lendai/esphome-house-pressure/enclosure/png/back.png

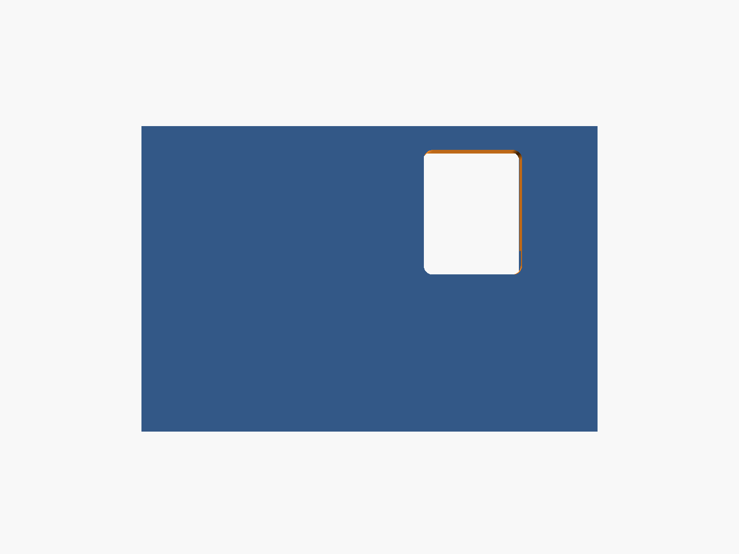
enclosure/png/back.png
