lendai/esphome-house-pressure/enclosure/png/base.png

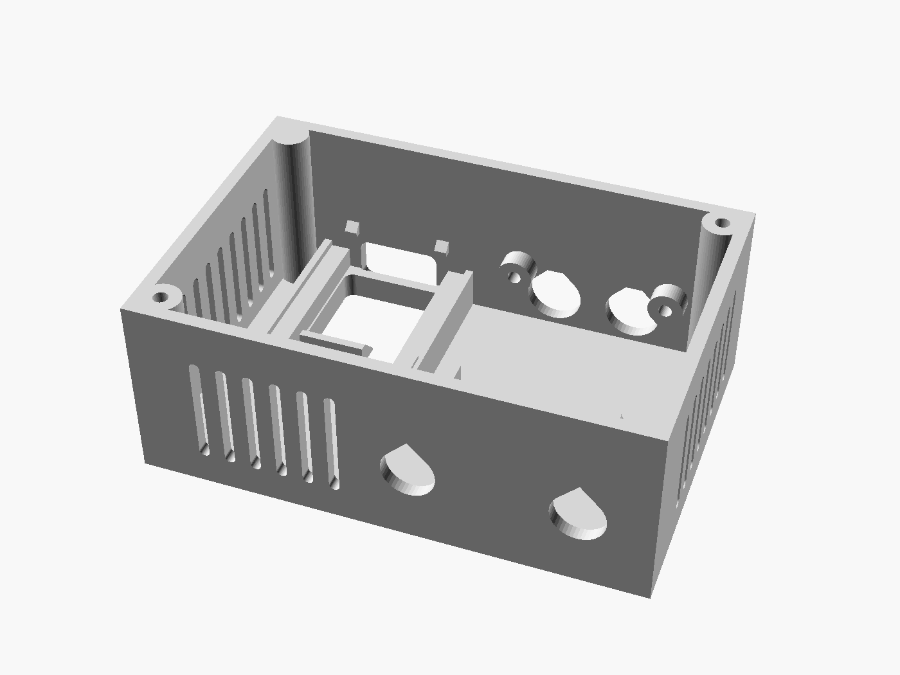
enclosure/png/base.png
