lendai/esphome-house-pressure/enclosure/png/coupon.png

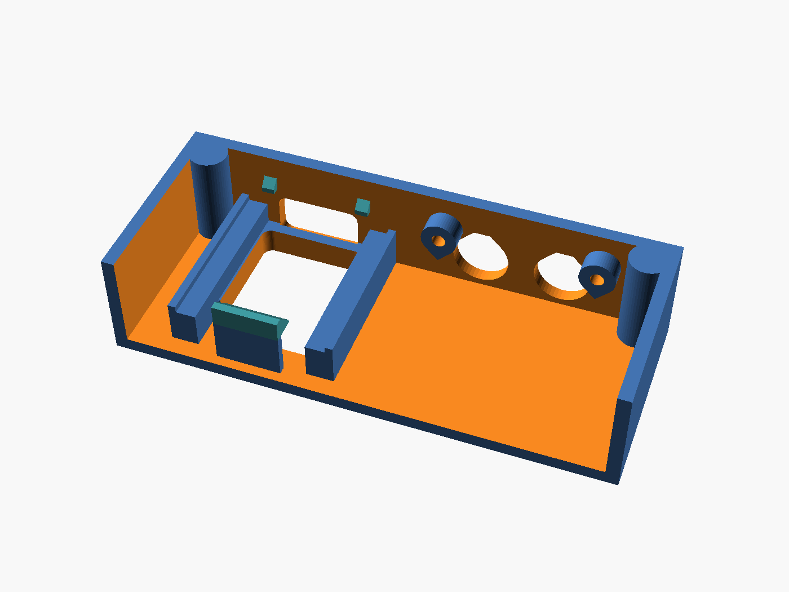
enclosure/png/coupon.png
