lendai/esphome-house-pressure/enclosure/png/lid.png

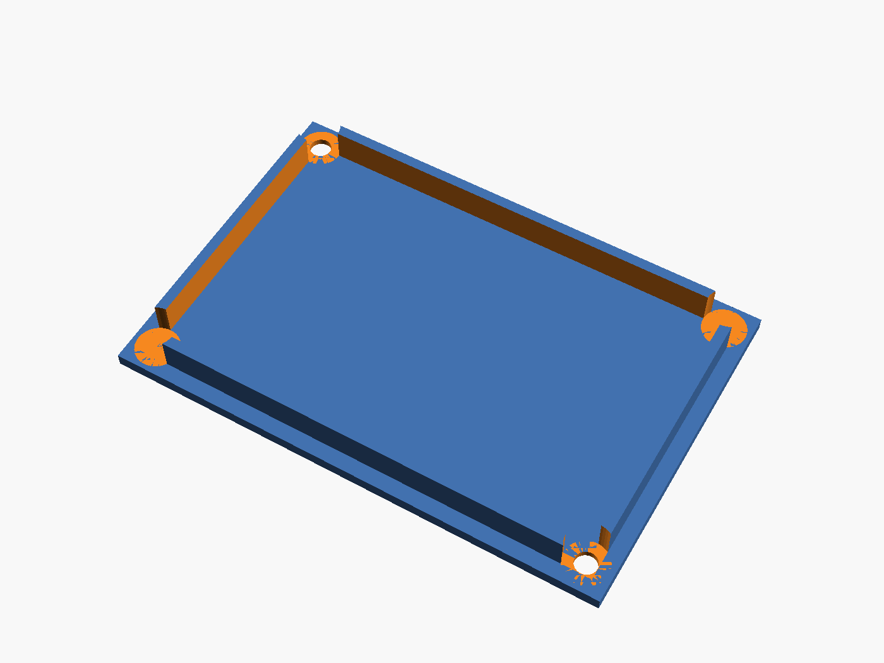
enclosure/png/lid.png
