lendai/esphome-house-pressure/enclosure/png/window-feedthrough.png

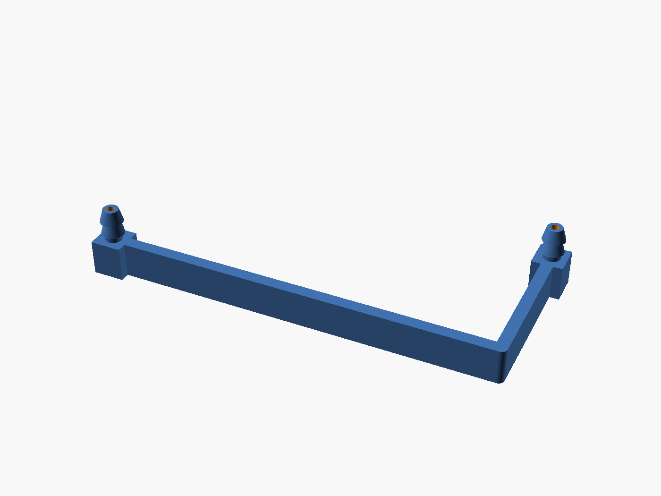
enclosure/png/window-feedthrough.png
