lendai/esphome-house-pressure/enclosure/stl/lid-text.stl

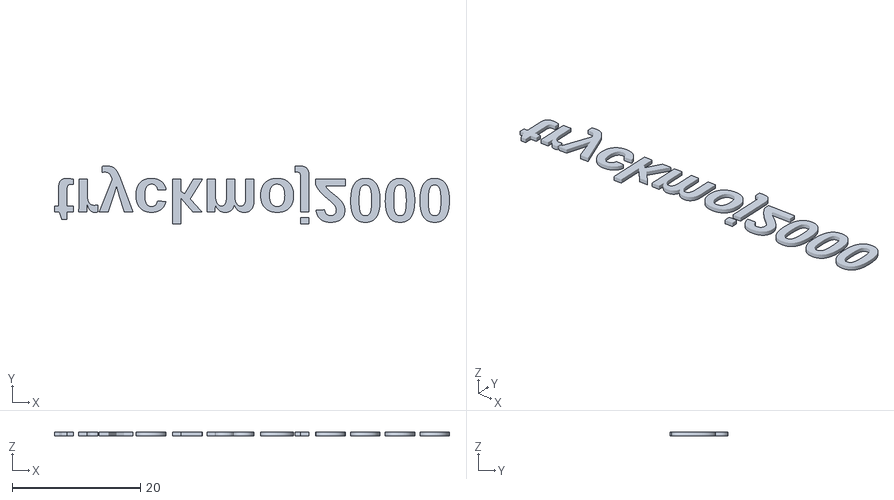
[picture p9: CAD file, 2026-10-29]
enclosure/stl/lid-text.stl
61.6 x 9.06 x 0.6
