lendai/esphome-house-pressure/enclosure/stl/lid-body.stl

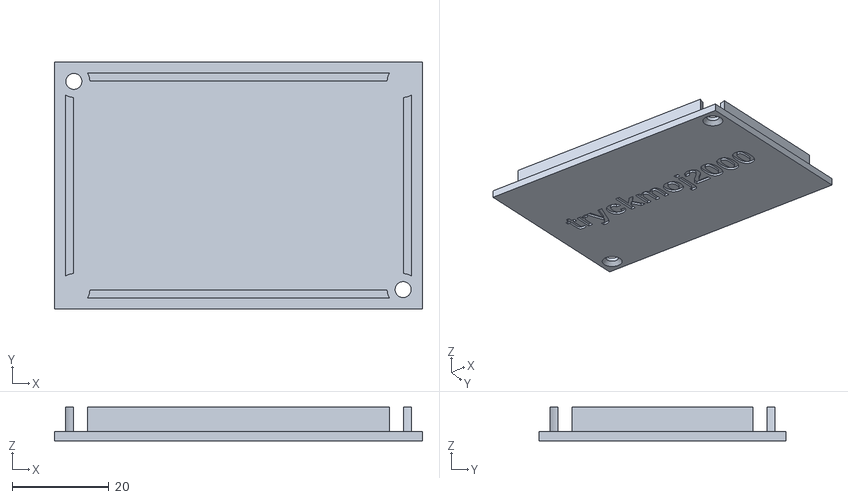
[picture p10: CAD file, 2026-10-29]
enclosure/stl/lid-body.stl
76.0 x 51.0 x 7.00
