lendai/esphome-house-pressure/enclosure/stl/base.stl

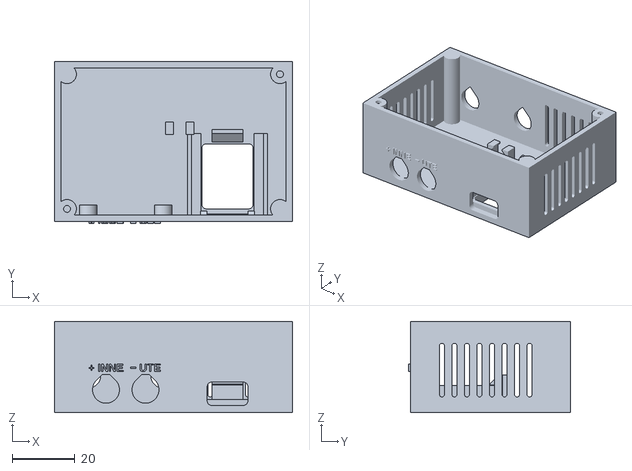
[picture p11: CAD file, 2026-10-29]
enclosure/stl/base.stl
76.0 x 51.6 x 29.1
