lendai/esphome-house-pressure/enclosure/stl/coupon.stl

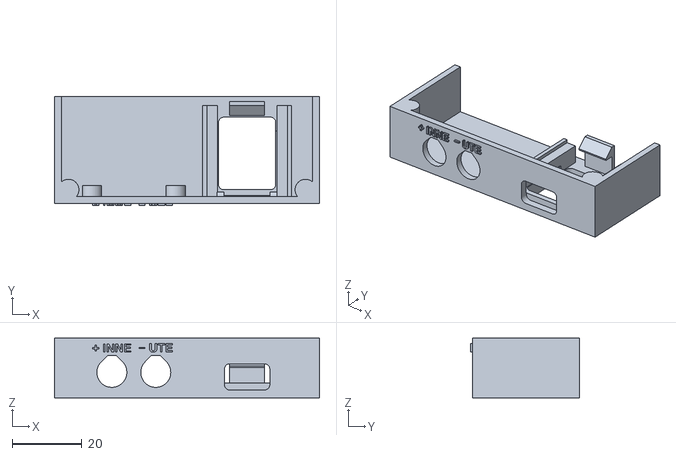
[picture p12: CAD file, 2026-10-28]
enclosure/stl/coupon.stl
76.0 x 31.4 x 17.1
