lendai/esphome-house-pressure/enclosure/stl/window-feedthrough.stl

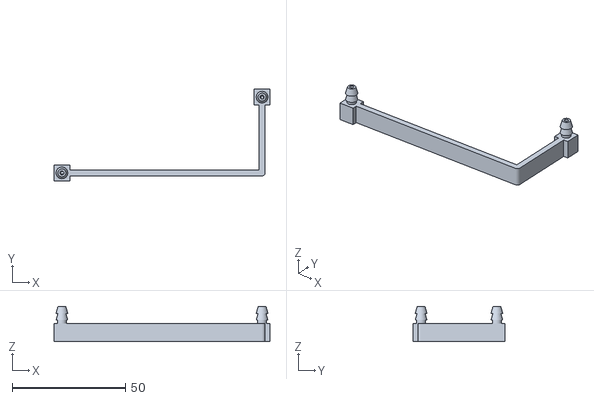
[picture p13: CAD file, 2026-10-28]
enclosure/stl/window-feedthrough.stl
95.5 x 40.5 x 15.5
