lendai/esphome-house-pressure/(list of files, cad)

Other CAD files:
enclosure/stl/lid.stl
