lendai/esphome-house-pressure/enclosure/png/assembly-bottom.png

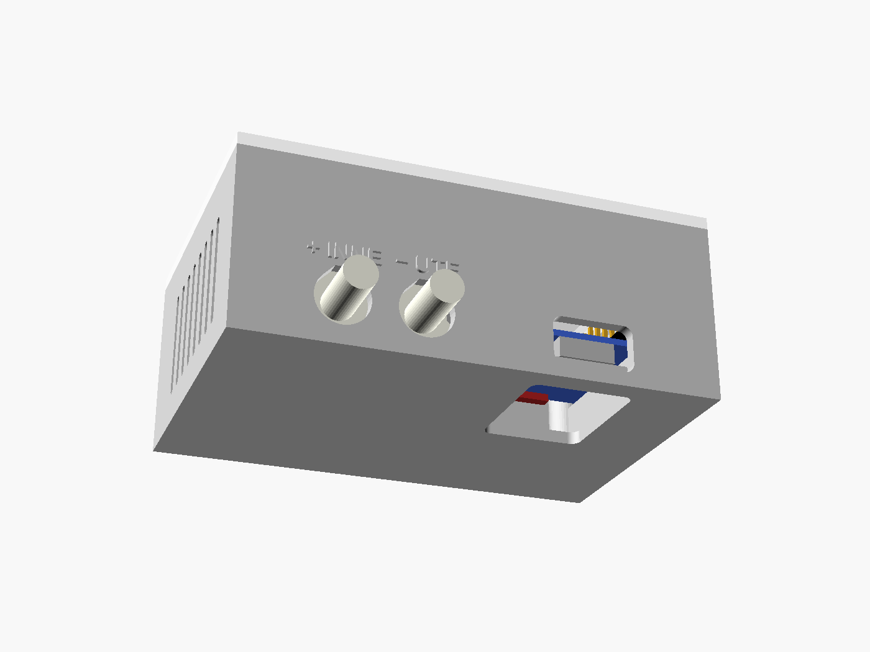
enclosure/png/assembly-bottom.png
