lendai/esphome-house-pressure/enclosure/png/assembly-inside.png

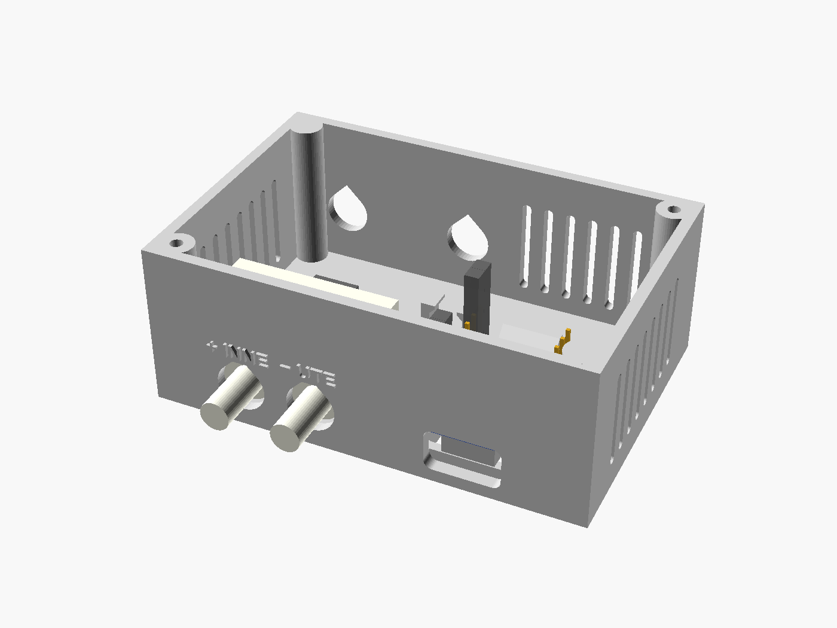
enclosure/png/assembly-inside.png
