lendai/esphome-house-pressure/house-pressure.yaml

substitutions:
  name: house-pressure
  friendly_name: House pressure

esphome:
  name: ${name}
  friendly_name: ${friendly_name}
  on_boot:
    priority: -100
    then:
      - if:
          condition:
            not:
              wifi.connected:
          then:
            - script.execute: led_no_wifi

# Waveshare ESP32-C3-Zero (ESP32-C3FH4, 4 MB flash, native USB Serial/JTAG)
esp32:
  variant: esp32c3
  board: esp32-c3-devkitm-1
  flash_size: 4MB
  framework:
    type: esp-idf

logger:

api:
  encryption:
    key: !secret api_encryption_key
  on_client_connected:
    - script.execute: led_ok
  on_client_disconnected:
    - if:
        condition:
          not:
            api.connected:
        then:
          - script.execute: led_no_homey

ota:
  - platform: esphome
    password: !secret ota_password

wifi:
  ssid: !secret wifi_ssid
  password: !secret wifi_password
  ap:
    ssid: "${name} fallback"
    password: !secret fallback_ap_password
  on_connect:
    - script.execute: led_no_homey
  on_disconnect:
    - script.execute: led_no_wifi

captive_portal:

# Onboard WS2812 on GPIO10 as status LED (Waveshare: RGB data order).
#   red pulse   = no WiFi
#   blue pulse  = WiFi OK, Homey not connected
#   dim green   = connected to Homey
light:
  - platform: esp32_rmt_led_strip
    id: status_led
    name: "Status LED"
    internal: true
    pin: GPIO10
    num_leds: 1
    chipset: WS2812
    channel_colors: RGB
    default_transition_length: 0s
    restore_mode: ALWAYS_OFF
    effects:
      - pulse:
          name: Pulse
          transition_length: 1s
          update_interval: 1s

script:
  - id: led_no_wifi
    mode: restart
    then:
      - light.turn_on:
          id: status_led
          red: 100%
          green: 0%
          blue: 0%
          brightness: 50%
          effect: Pulse
  - id: led_no_homey
    mode: restart
    then:
      - light.turn_on:
          id: status_led
          red: 0%
          green: 0%
          blue: 100%
          brightness: 50%
          effect: Pulse
  - id: led_ok
    mode: restart
    then:
      - light.turn_on:
          id: status_led
          red: 0%
          green: 100%
          blue: 0%
          brightness: 10%
          effect: None

# GPIO4/5: free on the C3-Zero (not strapping 2/8/9, not LED 10, not USB 18/19, not UART 20/21).
# External 4.7 kΩ pull-ups to 3.3 V, so internal pull-ups are off.
i2c:
  sda: GPIO4
  scl: GPIO5
  sda_pullup_enabled: false
  scl_pullup_enabled: false
  frequency: 100kHz
  scan: true

# Positive = "+" port (indoor) higher than "−" port (outdoor).
# Turn on if the tubes are swapped.
switch:
  - platform: template
    id: invert_sign
    name: "Invert pressure sign"
    icon: mdi:swap-vertical
    optimistic: true
    restore_mode: RESTORE_DEFAULT_OFF
    # Offset is stored in the displayed sign convention, so flip it with the sign.
    on_turn_on:
      - number.set:
          id: pressure_offset
          value: !lambda return -id(pressure_offset).state;
    on_turn_off:
      - number.set:
          id: pressure_offset
          value: !lambda return -id(pressure_offset).state;

number:
  - platform: template
    id: pressure_offset
    name: "Pressure offset"
    icon: mdi:tune-vertical
    unit_of_measurement: Pa
    device_class: pressure
    mode: box
    min_value: -25
    max_value: 25
    step: 0.01
    initial_value: 0
    optimistic: true
    restore_value: true

button:
  - platform: template
    name: "Zero calibrate"
    icon: mdi:scale-balance
    on_press:
      - lambda: |-
          float avg = id(pressure_avg).state;
          if (std::isnan(avg)) {
            ESP_LOGW("calib", "No average yet, calibration skipped");
            return;
          }
          // avg already has the old offset subtracted
          float offset = id(pressure_offset).state + avg;
          ESP_LOGI("calib", "New offset: %.2f Pa", offset);
          auto call = id(pressure_offset).make_call();
          call.set_value(offset);
          call.perform();

sensor:
  # sdp3x publishes hPa; convert to Pa. Sign/offset are applied on the outputs.
  - platform: sdp3x
    id: sdp_pa
    address: 0x25
    update_interval: 2s
    internal: true
    unit_of_measurement: Pa
    # Copies inherit this. Empty, so Homey's ESPHome app doesn't map them to
    # measure_pressure, convert Pa to mbar and round a few Pa down to 0.
    device_class: ""
    accuracy_decimals: 2
    filters:
      - multiply: 100

  - platform: copy
    source_id: sdp_pa
    id: pressure_raw
    name: "Pressure indoor-outdoor raw"
    unit_of_measurement: Pa
    state_class: measurement
    accuracy_decimals: 2
    filters:
      - throttle_average: 10s
      - lambda: |-
          return (id(invert_sign).state ? -x : x) - id(pressure_offset).state;

  - platform: copy
    source_id: sdp_pa
    id: pressure_avg
    name: "Pressure indoor-outdoor"
    unit_of_measurement: Pa
    state_class: measurement
    accuracy_decimals: 1
    filters:
      # 150 × 2 s = 5 min window, published every 30 s
      - sliding_window_moving_average:
          window_size: 150
          send_every: 15
          send_first_at: 15
      - lambda: |-
          return (id(invert_sign).state ? -x : x) - id(pressure_offset).state;

  - platform: wifi_signal
    name: "WiFi signal"
    update_interval: 60s

  - platform: uptime
    name: "Uptime"
