lendai/esphome-house-pressure/(commit log)

2026-10-26 Add ESPHome config for SDP810 indoor-outdoor pressure sensor
    ESP32-C3-Zero + SDP810-125Pa on I2C (GPIO4/5, external pull-ups),
    5-min average and raw pressure in Pa, zero-offset calibration,
    sign inversion, README with wiring and Homey setup.
2026-10-26 Show all entities as regular entities
    Drop entity_category from the sign switch, offset, zero-calibrate button
    and the WiFi/uptime sensors so they are not hidden as config/diagnostic.
2026-10-26 Add parametric 3D-printable enclosure
    OpenSCAD model for a wall-mounted box where the base is the carrier:
    SDP810 screwed to bosses on the bottom wall with ports out through it
    ("+ INNE" / "- UTE" embossed), ESP32-C3-Zero-M upside down in a snap
    cradle aligned with a USB-C cutout, wire clip, vents, keyholes, and a
    snap-fit or M3 lid. Includes exported STLs (base, lid, test coupon),
    preview PNGs, a build script and a manifold checker.
    README: pull-ups now go at the SDP810 end of the harness, no breadboard.
    [base.stl, coupon.stl, house-pressure-enclosure.scad, lid.stl]
2026-10-27 Use onboard RGB LED as status light
    Red pulse = no WiFi, blue pulse = no Homey connection, dim green = connected.
2026-10-28 Tune enclosure fit, screw the lid and add window feedthrough
    - Widen and lengthen the C3 cradle (c3_w_play 4.5, c3_l_play 2.0) and
    make the antenna-end snap tab sturdier (1.2 mm thick, 10 mm wide)
    - Screw the lid to four corner bosses with small wood screws by default
    - Enlarge the SDP810 screwdriver access holes to 8 mm
    - Replace the keyhole wall mounts with a back-plate window for reaching
    the C3 LED and BOOT/RESET buttons
    - Add a printable window-gap tube feedthrough
    [base.stl, coupon.stl, house-pressure-enclosure.scad, lid.stl, window-feedthrough.scad, window-feedthrough.stl]
2026-10-29 Show pressure in Pa in Homey
    Homey's ESPHome app maps device_class pressure to measure_pressure, converts
    Pa to mbar and rounds a few Pa down to 0. Clear the device class so the
    values show up as plain numbers in Pa.
2026-10-29 Add two-colour name lid and screw the lid at two diagonal corners
    - New lid_body / lid_text parts: "tryckmoj2000" inlaid 0.6 mm flush in
    the lid's outer face, for printing as one multi-material object
    - lid_screws = "diagonal" (default) drills only the bottom-left and
    top-right corners; all four bosses stay for alignment
    [base.stl, house-pressure-enclosure.scad, lid-body.stl, lid-text.stl, lid.stl]
